m1dh1v/Digital-Stethoscope/(commit log)

2026-11-09 Add files via upload
    Just shows peak whenever someone snaps near mic. For testing
    [Snap_peak_showing.ino]
2026-11-09 Avoiding double counting, adaptive threshold and more
    The most challanging part of software till now. I thought if I would take avg of max values and of base values and set threshold exactly in between to count pulse, it would be accurate. But it has the obvious flaw that threshold should change dynamically since a low quality mic+shaky hands=no identical peaks. So I tried giving a refractory period(min time between pulses to avoid double counting), adaptive threshold setting, using a schmidt trigger type logic to not count lub and dub or S1 and S2 separately, etc. To be honest, sometimes when I do a post-cardio measurement with the steth, my heartbeat which should be around 150 comes out to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
    [heartbeat_monitor_improvedlogic_h.ino]
2026-11-09 Seeing freq domain output
    so that we know what to filter. Tried to remove an unknown 60Hz hum.
2026-11-09 Add files via upload
    few images taken just after presenting the current progress(today) to the instructor. It went well and sir seemed happy
